MitchBradley/GeckoBlaster/(list of files, drawings)

Other design files:
DipTrace/MiniLPTStackWombat.dch
DipTrace/MiniLPTStackWombatSide.dip
